MiguelRoldao/ISEL_FinalProject/README.md

# ISEL_FinalProject
This project was made during my bachelor of Electronics and Telecommunications Engineering, as part of the end of course project (Projeto de Fim de Curso)
