MiguelRoldao/ISEL_FinalProject/Esquemático_do_projeto.pdf

# 4066N ¹⁰u 10u

# 100k 100k 1n

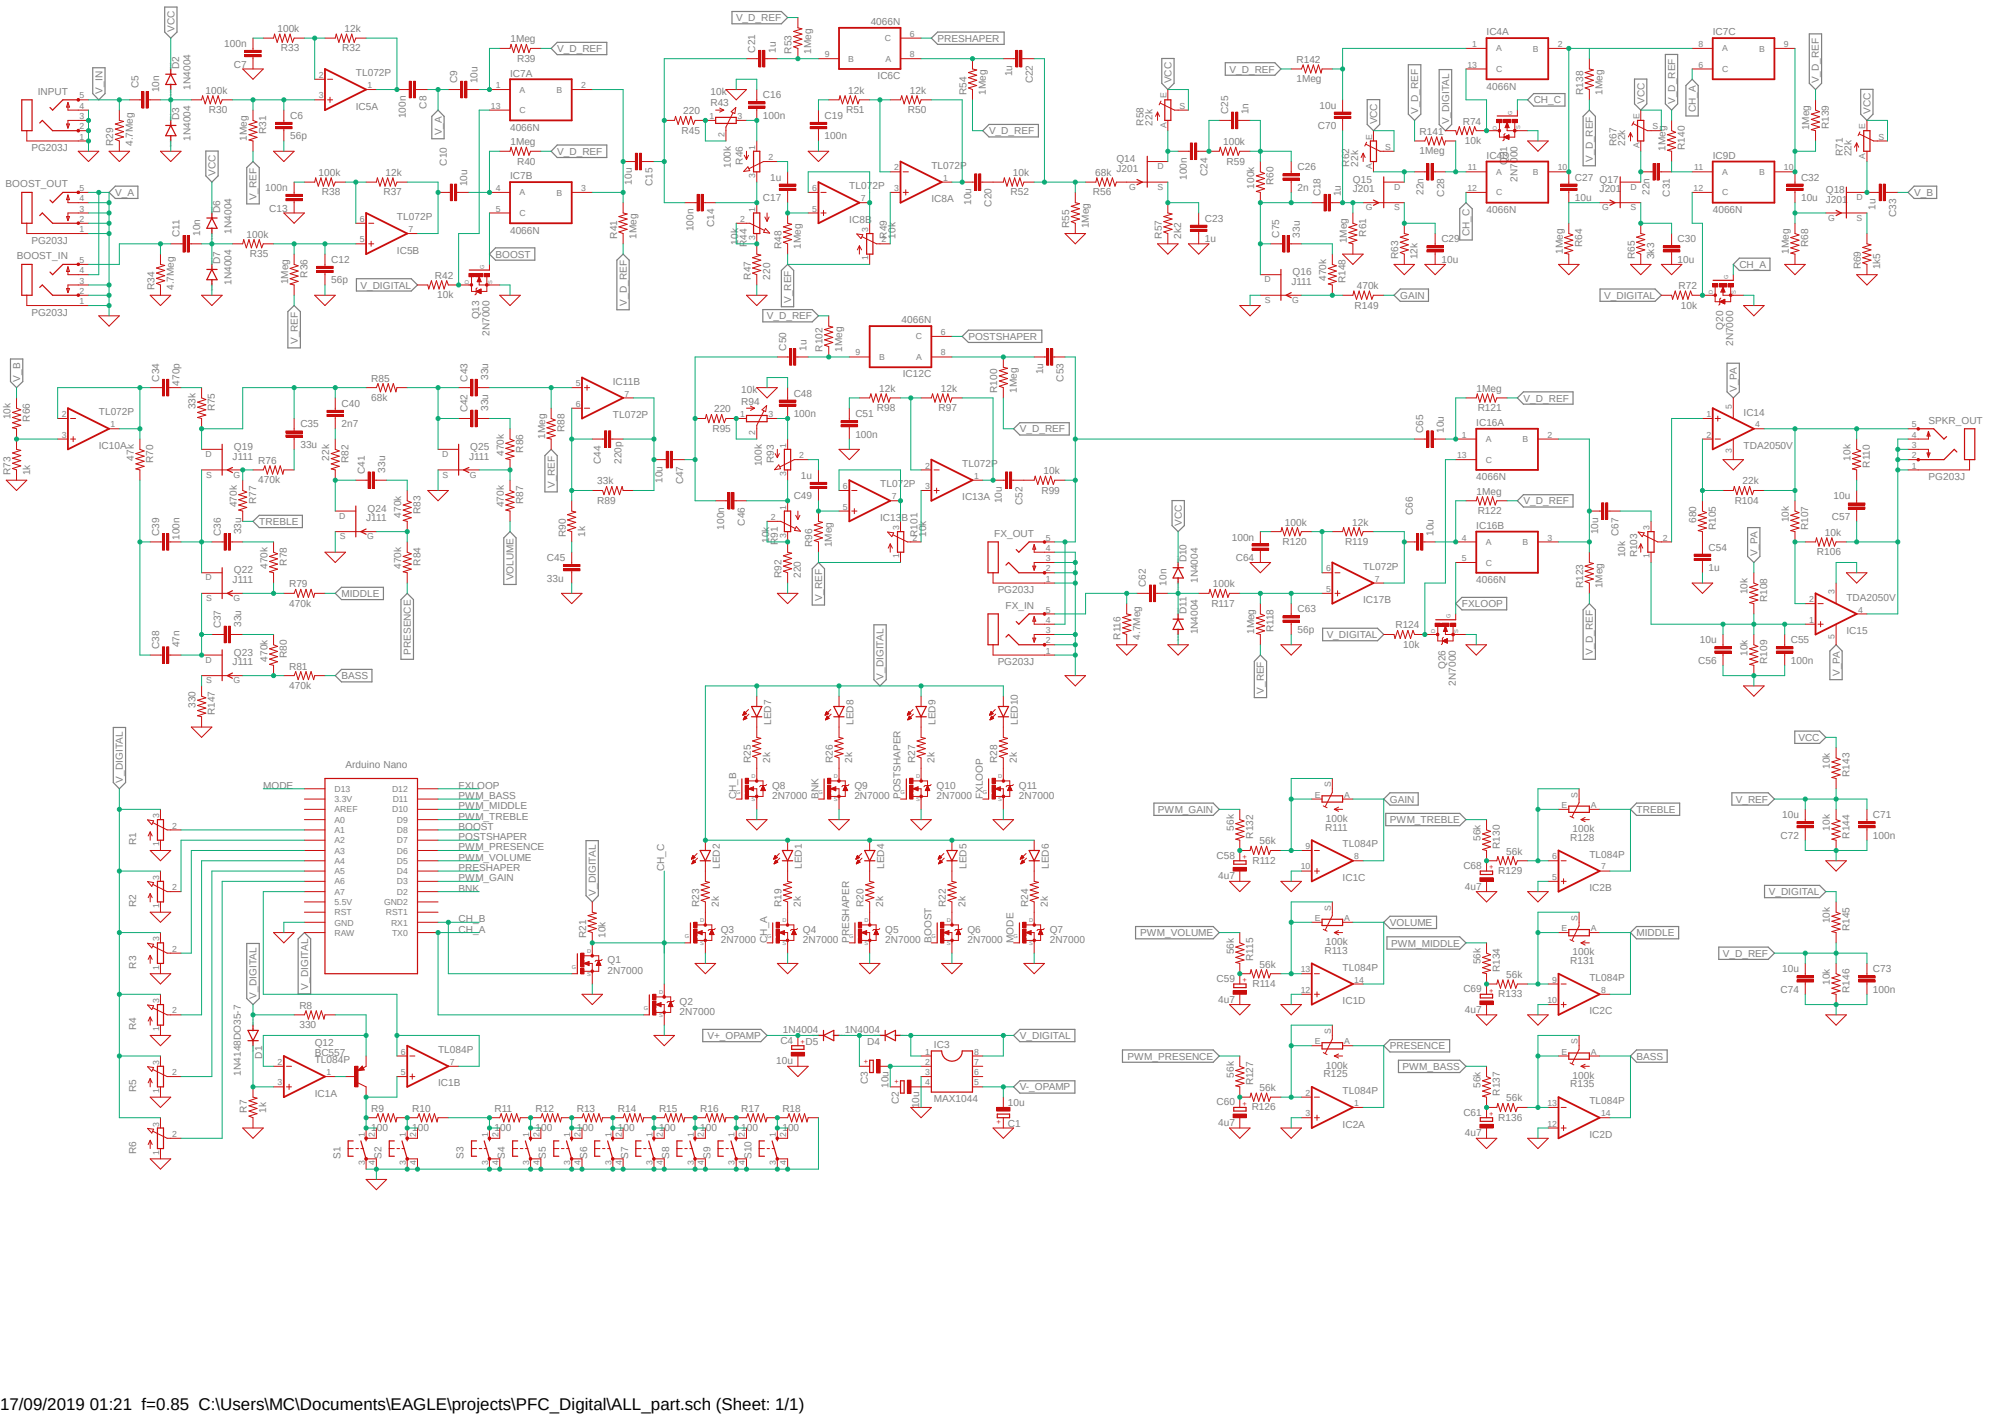
[picture p20: page 1]
